neilenns/CJ4-PFD-Menu-Panel/reference.png

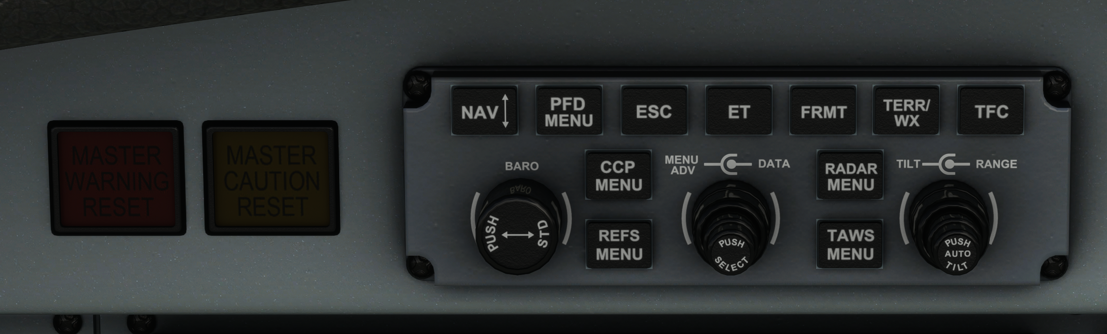
reference.png
