neilenns/CJ4-PFD-Menu-Panel/caution reference.png

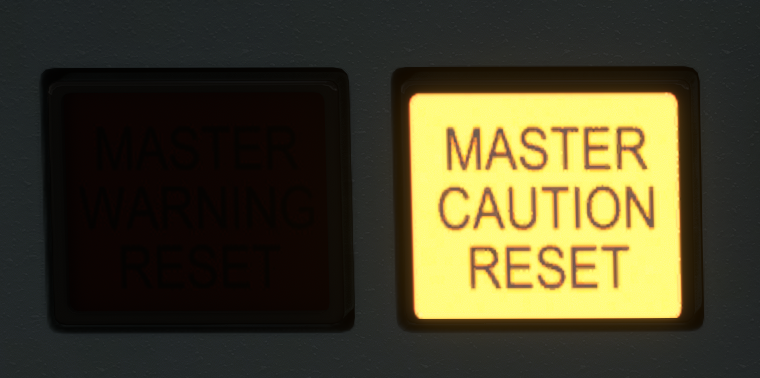
caution reference.png
