neilenns/CJ4-PFD-Menu-Panel/Button cap.stl

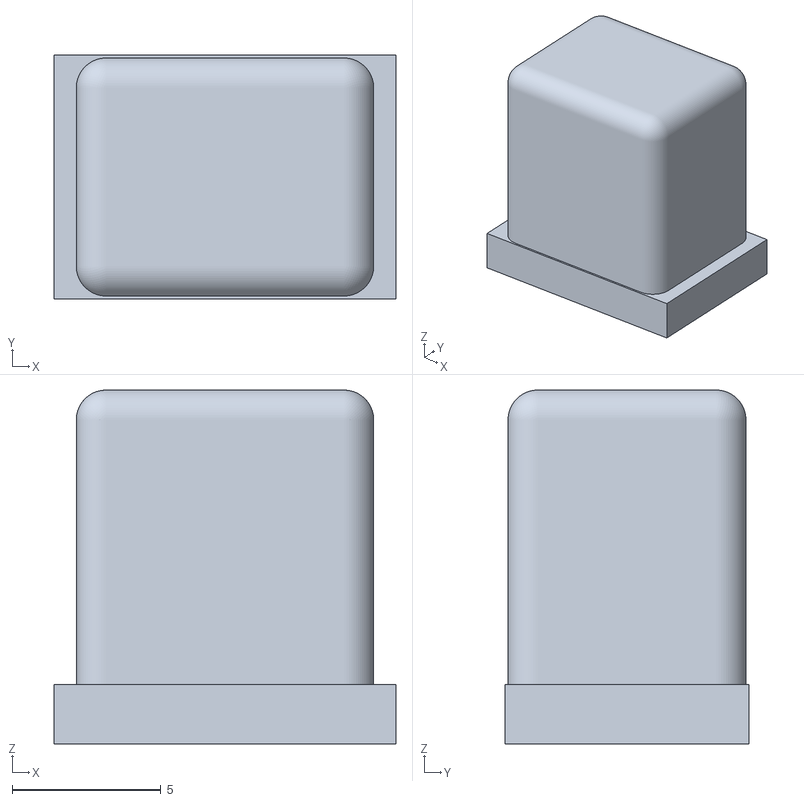
[picture p3: CAD file, 2022-12-13]
Button cap.stl
11.5 x 8.20 x 11.9
