neilenns/CJ4-PFD-Menu-Panel/CJ4-PFD-Menu-Panel.kicad_pcb

## KiCad design CJ4-PFD-Menu-Panel.kicad_pcb (2022-12-29)

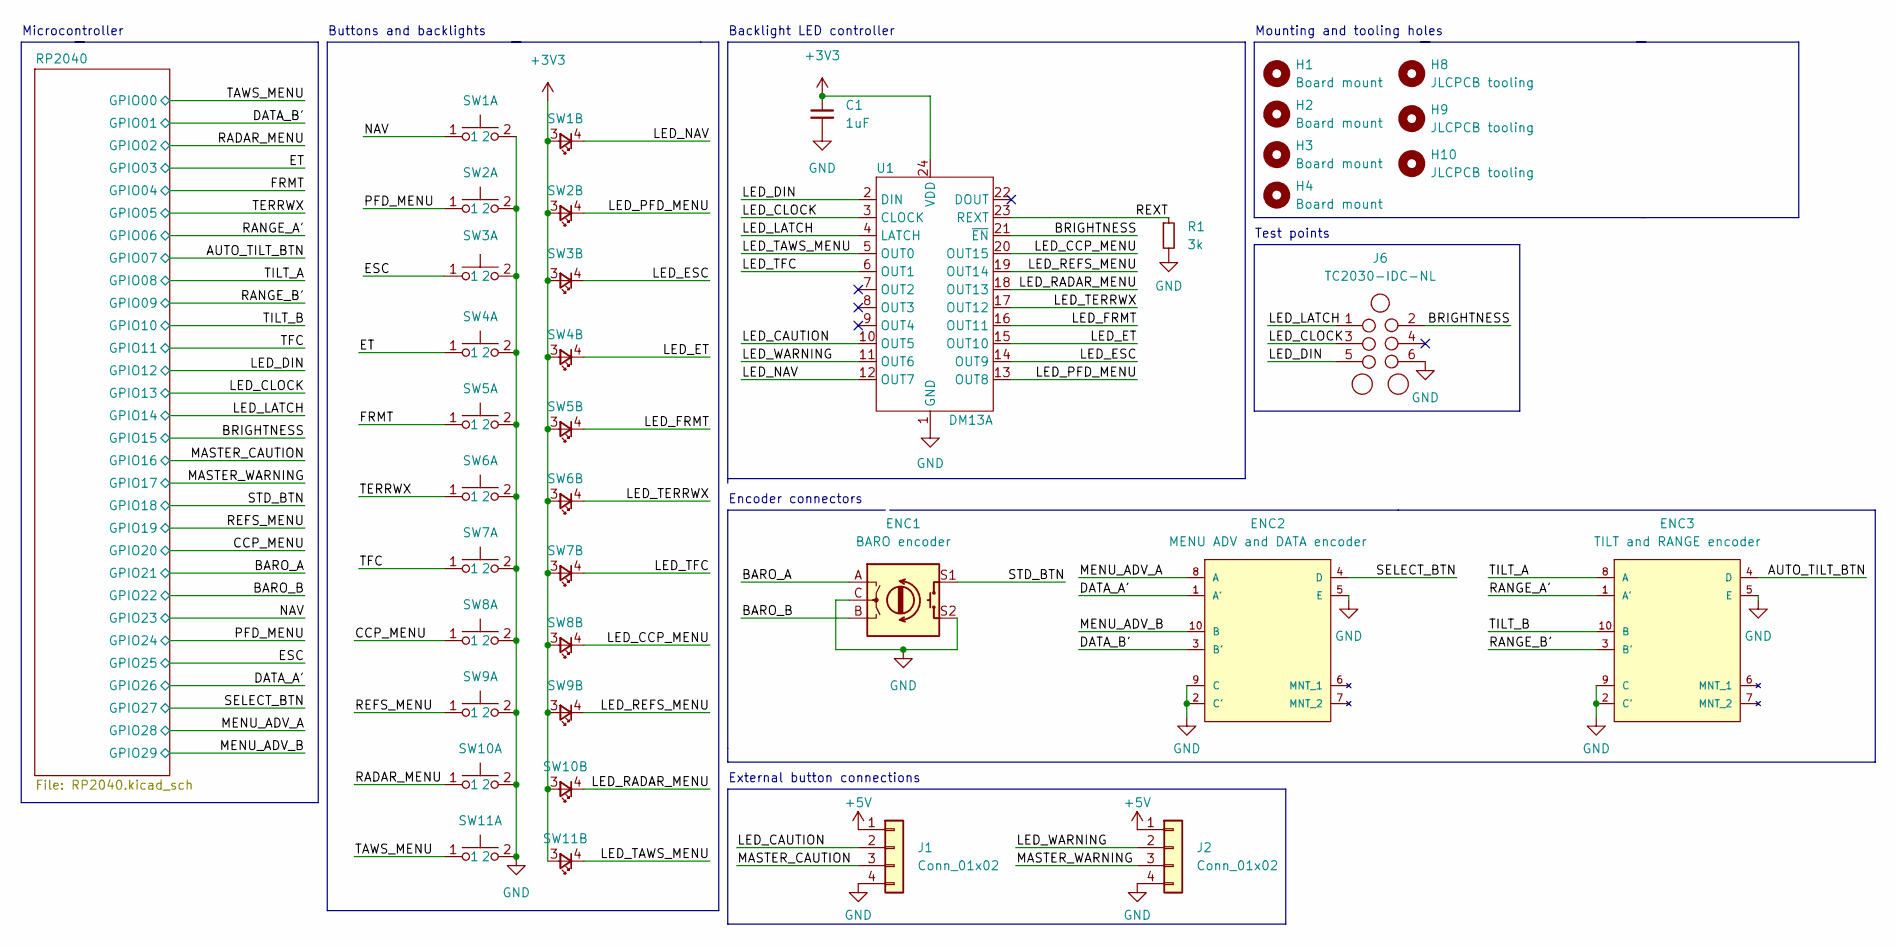
[picture p4: schematic CJ4-PFD-Menu-Panel.kicad_sch]

Parts:
C1: 1uF; Perfect_0402; JLC 0402
ENC1: BARO encoder; EN11-HSM1BF20_THT
ENC2: MENU ADV and DATA encoder; ALPS-EC11EBB24C03-0; Rating 10mA 5VDC; mouser part number 688-EC11EBB24C03
ENC3: TILT and RANGE encoder; ALPS-EC11EBB24C03-0; Rating 10mA 5VDC; mouser part number 688-EC11EBB24C03
H1, H2, H3, H4: Board mount; MountingHole_3.2mm_M3
H8, H9, H10: JLCPCB tooling; JLCPCB_Tooling_Hole
J1, J2: Conn_01x02; JST_XH_B4B-XH-A_1x04_P2.50mm_Vertical
J6: TC2030-IDC-NL; Tag-Connect_TC2030-IDC-NL_2x03_P1.27mm_Vertical
R1: 3k; R_0805_2012Metric_Pad1.20x1.40mm_HandSolder; JLC 0805
SW1, SW2, SW3, SW4, SW5, SW6, SW7, SW8, SW9, SW10, SW11: SW_PUSH_LED; SW_PUSH_LED_THT
U1: DM13A; SSOP-24_3.9x8.7mm_P0.635mm

Connections:
+3V3: C1.1, SW1.3, SW2.3, SW3.3, SW4.3, SW5.3, SW6.3, SW7.3, SW8.3, SW9.3, SW10.3, SW11.3, U1.24 (VDD); also elsewhere on the board
+5V: J1.1, J2.1; also elsewhere on the board
/AUTO_TILT_BTN: ENC3.4 (D); also elsewhere on the board
/BARO_A: ENC1.A; also elsewhere on the board
/BARO_B: ENC1.B; also elsewhere on the board
/BRIGHTNESS: J6.2, U1.21 (~EN); also elsewhere on the board
/CCP_MENU: SW8.1; also elsewhere on the board
/DATA_A': ENC2.1 (A'); also elsewhere on the board
/DATA_B': ENC2.3 (B'); also elsewhere on the board
/ESC: SW3.1; also elsewhere on the board
/ET: SW4.1; also elsewhere on the board
/FRMT: SW5.1; also elsewhere on the board
/LED_CAUTION: J1.2, U1.10 (OUT5)
/LED_CCP_MENU: SW8.4, U1.20 (OUT15)
/LED_CLOCK: J6.3, U1.3 (CLOCK); also elsewhere on the board
/LED_DIN: J6.5, U1.2 (DIN); also elsewhere on the board
/LED_ESC: SW3.4, U1.14 (OUT9)
/LED_ET: SW4.4, U1.15 (OUT10)
/LED_FRMT: SW5.4, U1.16 (OUT11)
/LED_LATCH: J6.1, U1.4 (LATCH); also elsewhere on the board
/LED_NAV: SW1.4, U1.12 (OUT7)
/LED_PFD_MENU: SW2.4, U1.13 (OUT8)
/LED_RADAR_MENU: SW10.4, U1.18 (OUT13)
/LED_REFS_MENU: SW9.4, U1.19 (OUT14)
/LED_TAWS_MENU: SW11.4, U1.5 (OUT0)
/LED_TERRWX: SW6.4, U1.17 (OUT12)
/LED_TFC: SW7.4, U1.6 (OUT1)
/LED_WARNING: J2.2, U1.11 (OUT6)
/MASTER_CAUTION: J1.3; also elsewhere on the board
/MASTER_WARNING: J2.3; also elsewhere on the board
/MENU_ADV_A: ENC2.8 (A); also elsewhere on the board
/MENU_ADV_B: ENC2.10 (B); also elsewhere on the board
/NAV: SW1.1; also elsewhere on the board
/PFD_MENU: SW2.1; also elsewhere on the board
/RADAR_MENU: SW10.1; also elsewhere on the board
/RANGE_A': ENC3.1 (A'); also elsewhere on the board
/RANGE_B': ENC3.3 (B'); also elsewhere on the board
/REFS_MENU: SW9.1; also elsewhere on the board
/REXT: R1.1, U1.23 (REXT)
/SELECT_BTN: ENC2.4 (D); also elsewhere on the board
/STD_BTN: ENC1.S1; also elsewhere on the board
/TAWS_MENU: SW11.1; also elsewhere on the board
/TERRWX: SW6.1; also elsewhere on the board
/TFC: SW7.1; also elsewhere on the board
/TILT_A: ENC3.8 (A); also elsewhere on the board
/TILT_B: ENC3.10 (B); also elsewhere on the board
GND: C1.2, ENC1.C, ENC1.S2, ENC2.2 (C'), ENC2.5 (E), ENC2.9 (C), ENC3.2 (C'), ENC3.5 (E), ENC3.9 (C), J1.4, J2.4, J6.6, R1.2, SW1.2, SW2.2, SW3.2, SW4.2, SW5.2, SW6.2, SW7.2, SW8.2, SW9.2, SW10.2, SW11.2, U1.1 (GND); also elsewhere on the board

Notes on the sheet:
Mounting and tooling holes
Microcontroller
Buttons and backlights
Backlight LED controller
Test points
Encoder connectors
External button connections

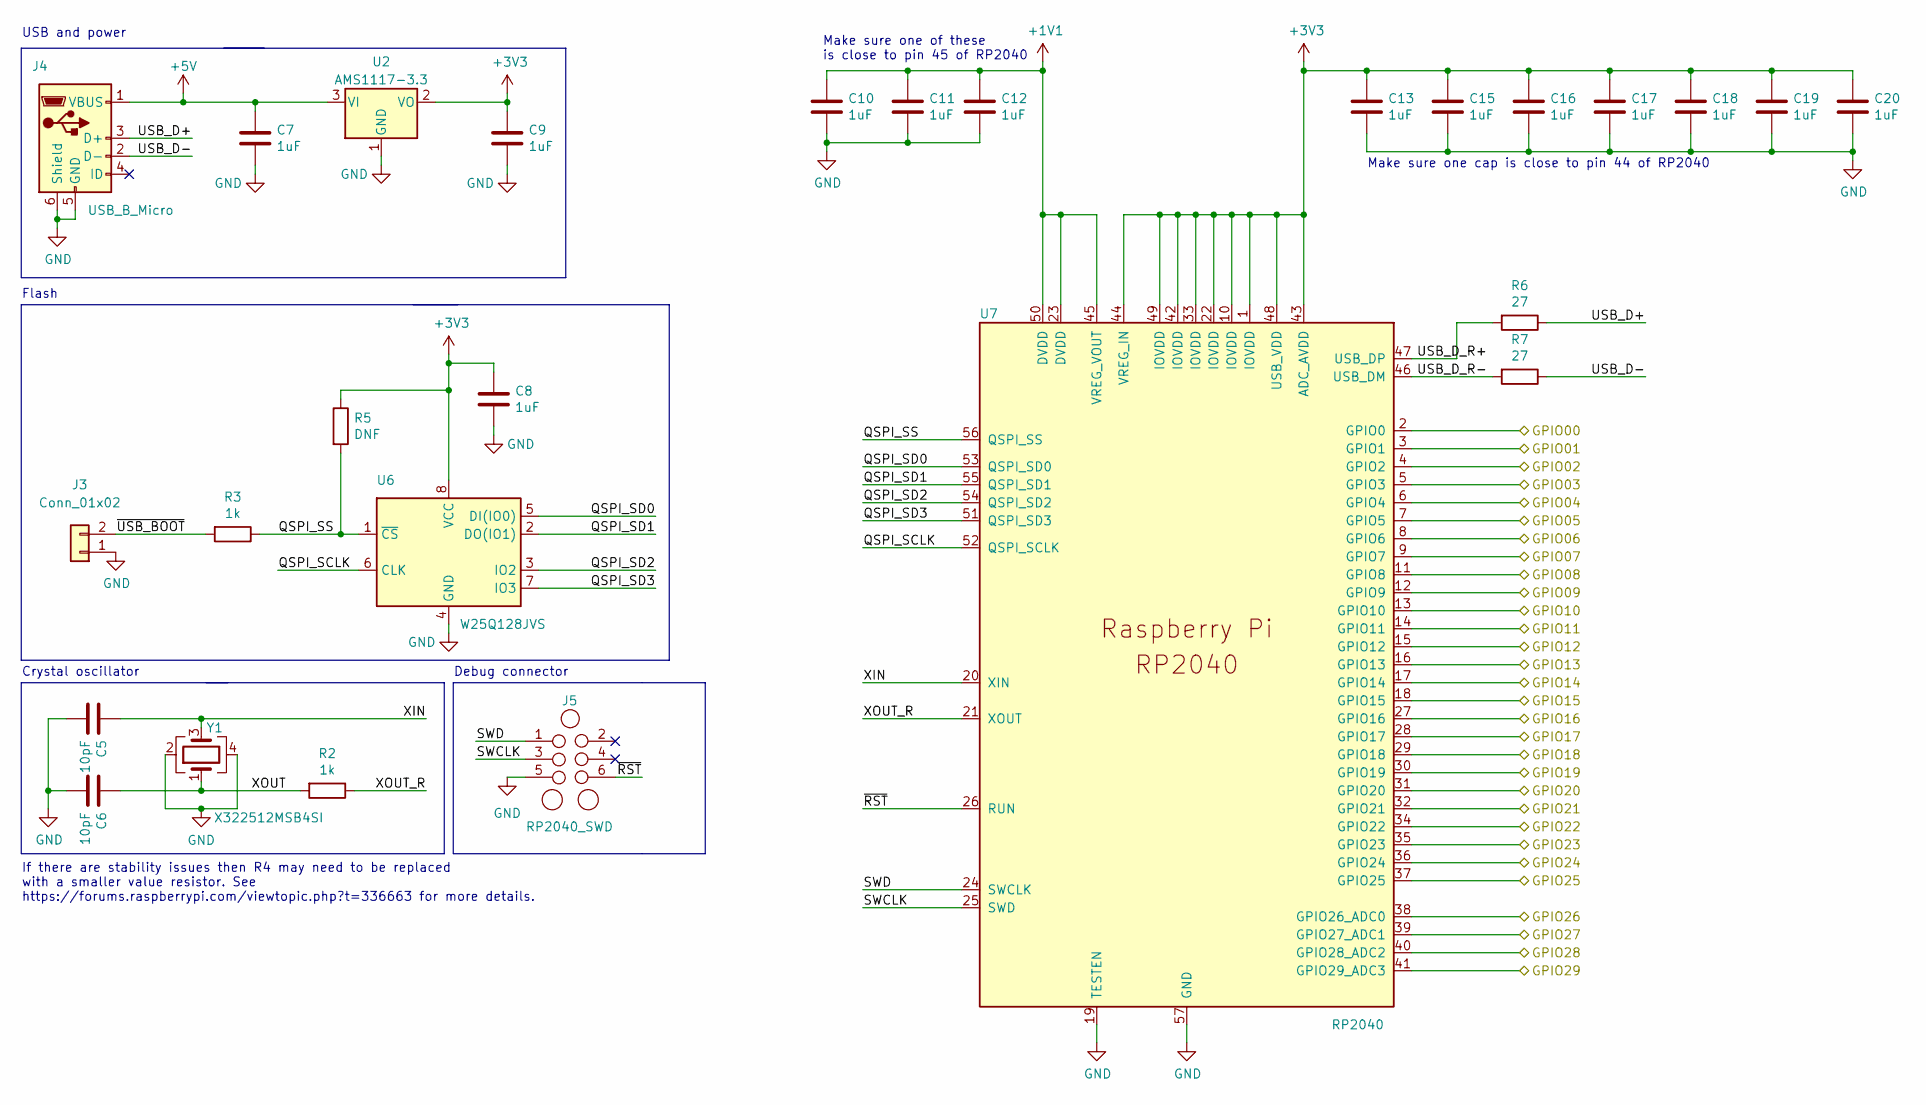
[picture p5: schematic RP2040.kicad_sch]

Parts:
C5, C6: 10pF; Perfect_0402; JLC 0402
C7, C8, C9, C10, C11, C12, C13, C15, C16, C17, C18, C19, C20: 1uF; Perfect_0402; JLC 0402
J3: Conn_01x02; PinHeader_1x02_P2.54mm_Vertical
J4: USB_B_Micro; USB_B_Mini_Amphenol_UE25BE5510H
J5: RP2040_SWD; Tag-Connect_TC2030-IDC-NL_2x03_P1.27mm_Vertical
R2, R3: 1k; Perfect_0402; JLC 0402
R5: DNF; R_1206_3216Metric_Pad1.30x1.75mm_HandSolder
R6, R7: 27; R_0603_1608Metric; JLC 0603
U2: AMS1117-3.3; SOT-223-3_TabPin2; JLC SOT-223
U6: W25Q128JVS; SOIC-8_5.23x5.23mm_P1.27mm; JLC SOIC-8-208mil
U7: RP2040; QFN56P40_700X700X90L40X18T310N; JLC LQFN-56_EP_7.0x7.0x0.4P
Y1: X322512MSB4SI; Crystal_SMD_3225-4Pin_3.2x2.5mm; JLC SMD-3225_4P

Connections:
+1V1: C10.1, C11.1, C12.1, U7.23 (DVDD), U7.45 (VREG_VOUT), U7.50 (DVDD)
+3V3: C8.1, C9.1, C13.1, C15.1, C16.1, C17.1, C18.1, C19.1, C20.1, R5.1, U2.2 (VO), U6.8 (VCC), U7.1 (IOVDD), U7.10 (IOVDD), U7.22 (IOVDD), U7.33 (IOVDD), U7.42 (IOVDD), U7.43 (ADC_AVDD), U7.44 (VREG_IN), U7.48 (USB_VDD), U7.49 (IOVDD); also elsewhere on the board
+5V: C7.1, J4.1 (VBUS), U2.3 (VI); also elsewhere on the board
/AUTO_TILT_BTN: U7.9 (GPIO7); also elsewhere on the board
/BARO_A: U7.32 (GPIO21); also elsewhere on the board
/BARO_B: U7.34 (GPIO22); also elsewhere on the board
/BRIGHTNESS: U7.18 (GPIO15); also elsewhere on the board
/CCP_MENU: U7.31 (GPIO20); also elsewhere on the board
/DATA_A': U7.38 (GPIO26_ADC0); also elsewhere on the board
/DATA_B': U7.3 (GPIO1); also elsewhere on the board
/ESC: U7.37 (GPIO25); also elsewhere on the board
/ET: U7.5 (GPIO3); also elsewhere on the board
/FRMT: U7.6 (GPIO4); also elsewhere on the board
/LED_CLOCK: U7.16 (GPIO13); also elsewhere on the board
/LED_DIN: U7.15 (GPIO12); also elsewhere on the board
/LED_LATCH: U7.17 (GPIO14); also elsewhere on the board
/MASTER_CAUTION: U7.27 (GPIO16); also elsewhere on the board
/MASTER_WARNING: U7.28 (GPIO17); also elsewhere on the board
/MENU_ADV_A: U7.40 (GPIO28_ADC2); also elsewhere on the board
/MENU_ADV_B: U7.41 (GPIO29_ADC3); also elsewhere on the board
/NAV: U7.35 (GPIO23); also elsewhere on the board
/PFD_MENU: U7.36 (GPIO24); also elsewhere on the board
/RADAR_MENU: U7.4 (GPIO2); also elsewhere on the board
/RANGE_A': U7.8 (GPIO6); also elsewhere on the board
/RANGE_B': U7.12 (GPIO9); also elsewhere on the board
/REFS_MENU: U7.30 (GPIO19); also elsewhere on the board
/RP2040/QSPI_SCLK: U6.6 (CLK), U7.52 (QSPI_SCLK)
/RP2040/QSPI_SD0: U6.5 (DI(IO0)), U7.53 (QSPI_SD0)
/RP2040/QSPI_SD1: U6.2 (DO(IO1)), U7.55 (QSPI_SD1)
/RP2040/QSPI_SD2: U6.3 (IO2), U7.54 (QSPI_SD2)
/RP2040/QSPI_SD3: U6.7 (IO3), U7.51 (QSPI_SD3)
/RP2040/QSPI_SS: R3.1, R5.2, U6.1 (~CS), U7.56 (QSPI_SS)
/RP2040/SWCLK: J5.3, U7.25 (SWD)
/RP2040/SWD: J5.1, U7.24 (SWCLK)
/RP2040/USB_D+: J4.3 (D+), R6.1
/RP2040/USB_D-: J4.2 (D-), R7.1
/RP2040/USB_D_R+: R6.2, U7.47 (USB_DP)
/RP2040/USB_D_R-: R7.2, U7.46 (USB_DM)
/RP2040/XIN: C5.1, U7.20 (XIN), Y1.3
/RP2040/XOUT: C6.1, R2.2, Y1.1
/RP2040/XOUT_R: R2.1, U7.21 (XOUT)
/RP2040/~RST: J5.6, U7.26 (RUN)
/RP2040/~USB_BOOT: J3.2, R3.2
/SELECT_BTN: U7.39 (GPIO27_ADC1); also elsewhere on the board
/STD_BTN: U7.29 (GPIO18); also elsewhere on the board
/TAWS_MENU: U7.2 (GPIO0); also elsewhere on the board
/TERRWX: U7.7 (GPIO5); also elsewhere on the board
/TFC: U7.14 (GPIO11); also elsewhere on the board
/TILT_A: U7.11 (GPIO8); also elsewhere on the board
/TILT_B: U7.13 (GPIO10); also elsewhere on the board
GND: C5.2, C6.2, C7.2, C8.2, C9.2, C10.2, C11.2, C12.2, C13.2, C15.2, C16.2, C17.2, C18.2, C19.2, C20.2, J3.1, J4.5 (GND), J4.6 (Shield), J5.5, U2.1 (GND), U6.4 (GND), U7.19 (TESTEN), U7.57 (GND), Y1.2, Y1.4; also elsewhere on the board

Notes on the sheet:
If there are stability issues then R4 may need to be replaced with a smaller value resistor. See https://forums.raspberrypi.com/viewtopic.php?t=336663 for more details.
Make sure one cap is close to pin 44 of RP2040
Crystal oscillator
USB and power
Flash
Debug connector
Make sure one of these is close to pin 45 of RP2040

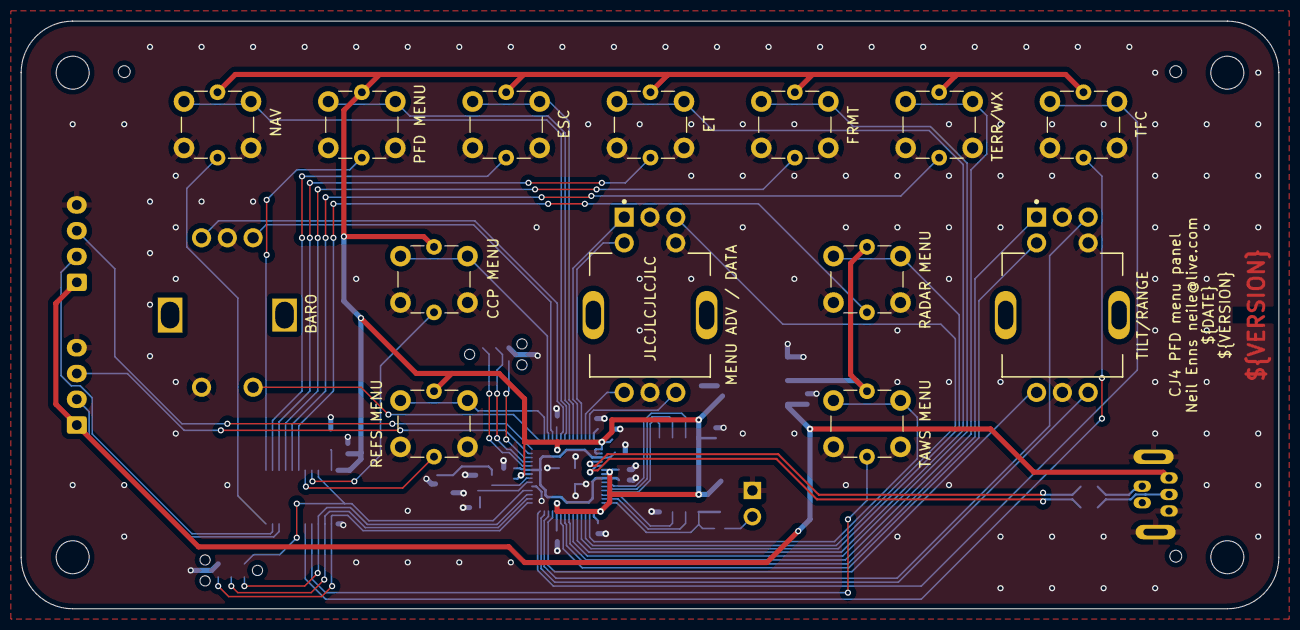
[picture p6: board CJ4-PFD-Menu-Panel.kicad_pcb from above]

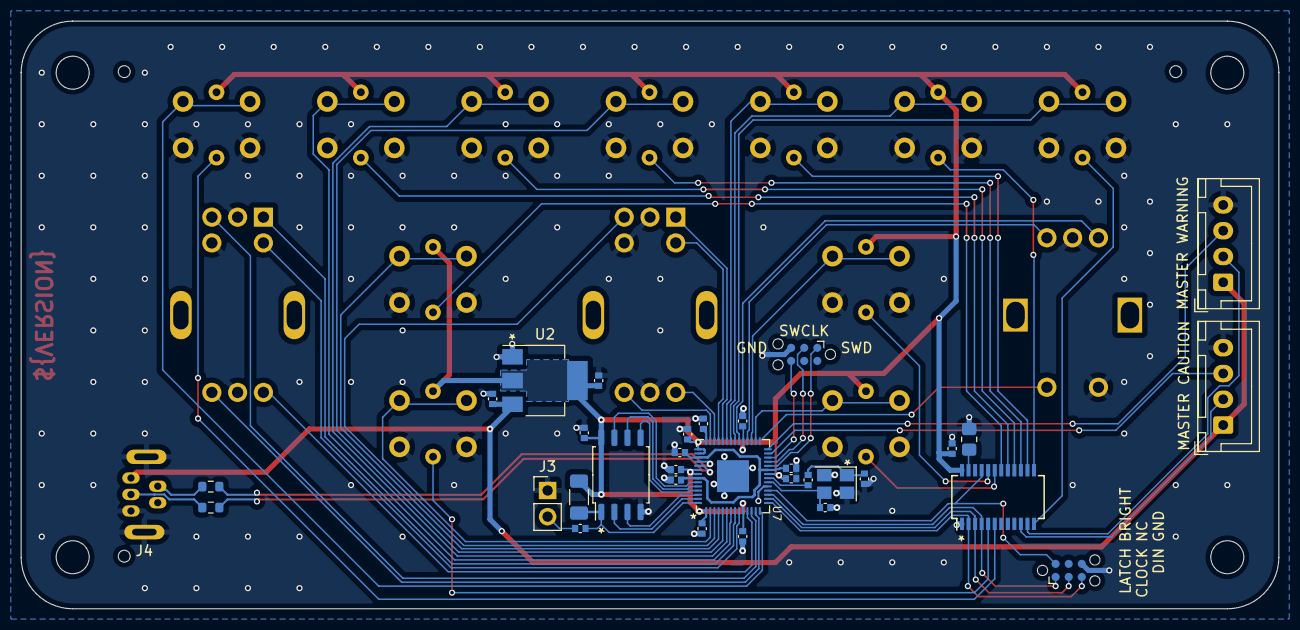
[picture p7: board CJ4-PFD-Menu-Panel.kicad_pcb from below]

Board: 2 copper layers, 122.0 x 57.0 mm, 54 parts (36 on the bottom side), 65 nets.
