neilenns/CJ4-PFD-Menu-Panel/(commit log)

2022-12-04 RP2040 design
    [CJ4-PFD-Menu-Panel.kicad_pcb, CJ4-PFD-Menu-Panel.kicad_sch, RP2040.kicad_sch]
2022-12-04 Add TCA8418
    [CJ4-PFD-Menu-Panel.kicad_sch, RP2040.kicad_sch]
2022-12-04 Expose the GPIO pins
    [CJ4-PFD-Menu-Panel.kicad_sch, RP2040.kicad_sch]
2022-12-04 Buttons and LED driver
    [CJ4-PFD-Menu-Panel.kicad_sch]
2022-12-05 Initial schematic complete
    [CJ4-PFD-Menu-Panel.kicad_pcb, CJ4-PFD-Menu-Panel.kicad_sch, RP2040.kicad_sch]
2022-12-06 More updates
    [CJ4-PFD-Menu-Panel.kicad_sch, RP2040.kicad_sch]
2022-12-06 Some board layout work
    [CJ4-PFD-Menu-Panel.kicad_pcb, CJ4-PFD-Menu-Panel.kicad_sch, RP2040.kicad_sch]
2022-12-12 Redo RP2040 layout
    [CJ4-PFD-Menu-Panel.kicad_pcb, CJ4-PFD-Menu-Panel.kicad_sch, RP2040.kicad_sch]
2022-12-12 Fully routed!
    [CJ4-PFD-Menu-Panel.kicad_pcb, CJ4-PFD-Menu-Panel.kicad_sch, RP2040.kicad_sch]
2022-12-12 Update external button connector, 3d models
    [CJ4-PFD-Menu-Panel.kicad_pcb, CJ4-PFD-Menu-Panel.kicad_sch, RP2040.kicad_sch]
2022-12-12 Cleanup silkscreen and version/date
    [CJ4-PFD-Menu-Panel.kicad_pcb, CJ4-PFD-Menu-Panel.kicad_sch, RP2040.kicad_sch]
2022-12-12 Silkscreen and date/version stuff
    [CJ4-PFD-Menu-Panel.kicad_pcb, CJ4-PFD-Menu-Panel.kicad_sch, RP2040.kicad_sch]
2022-12-13 Fix encoder wiring
    [CJ4-PFD-Menu-Panel.kicad_pcb, CJ4-PFD-Menu-Panel.kicad_sch]
2022-12-13 Add debug connections
    [Button cap.stl, CJ4-PFD-Menu-Panel.kicad_pcb, CJ4-PFD-Menu-Panel.kicad_sch, RP2040.kicad_sch]
2022-12-14 Final changes prior to ordering
    [CJ4-PFD-Menu-Panel.kicad_pcb, CJ4-PFD-Menu-Panel.kicad_sch, RP2040.kicad_sch]
2022-12-14 Update part rotation
    [CJ4-PFD-Menu-Panel.kicad_pcb]
2022-12-14 Fix copper fill, add via stitching
    [CJ4-PFD-Menu-Panel.kicad_pcb]
2022-12-29 Fix the footprints, add stuff
    [CJ4-PFD-Menu-Panel.kicad_pcb]
